teamSequint/sequint/sequint.brd

## EAGLE design sequint.brd (2012-04-18)

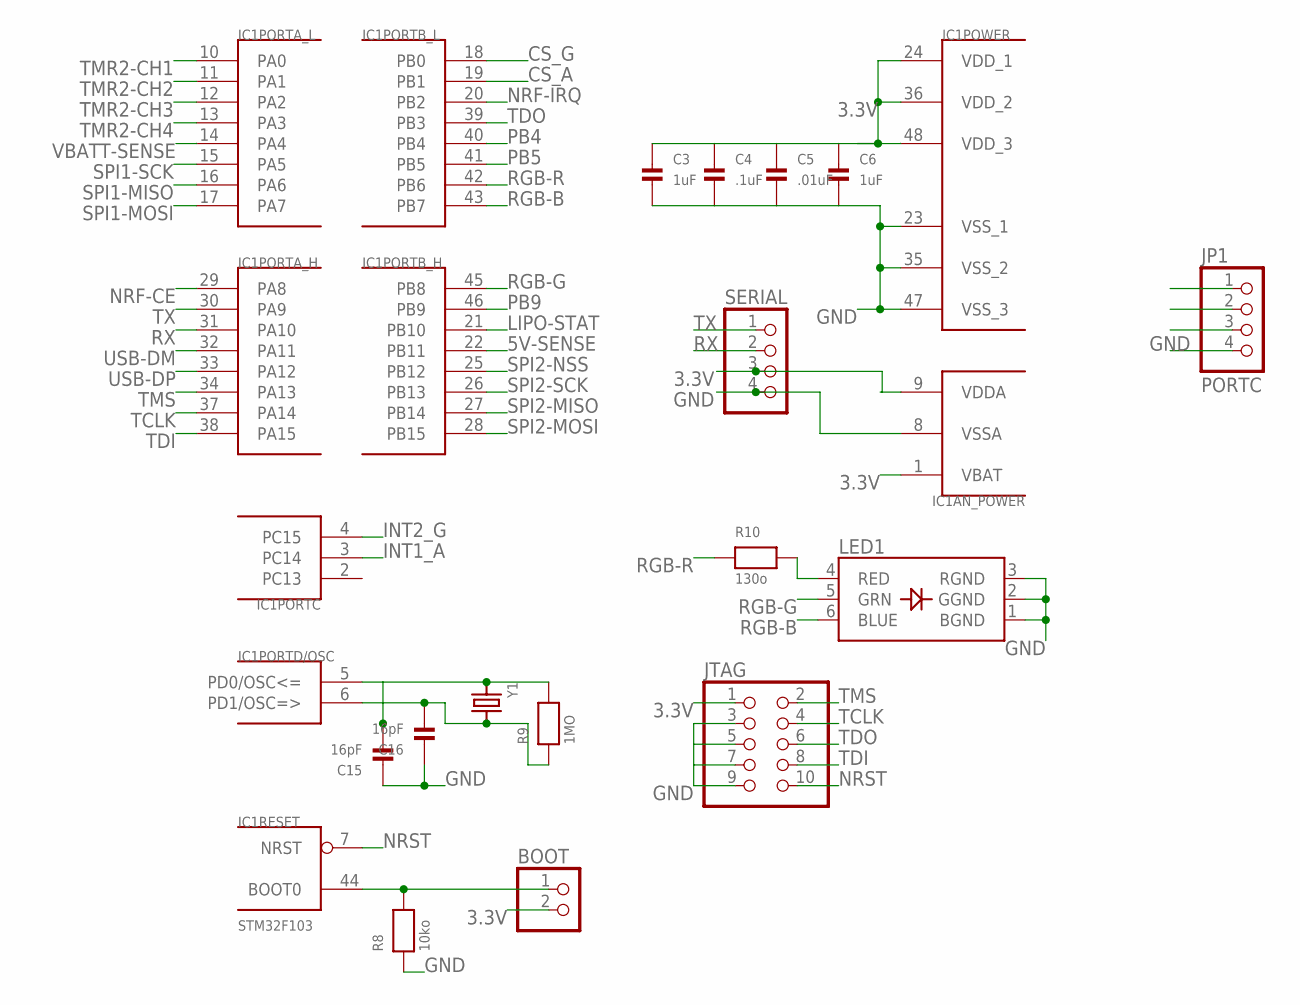
[picture p1: schematic sequint.sch, sheet 1]

Parts:
BOOT: HEADER-1X2ROUND; 1X02_ROUND
C3, C6: 1uF; 0402
C4: .1uF; 0402
C5: .01uF; 0402
C15, C16: 16pF; 0402
IC1: STM32F103; TQFP48
JP1: PORTC; 1X04_ROUND
JTAG: HEADER-2X5; 2X05
LED1: LED_RGB_PLCC6CREE-CLV6A; RGBLED_PLCC6
R8: 10ko; 0402
R9: 1MO; 0402
R10: 130o; 0402
SERIAL: HEADER-1X4ROUND; 1X04_ROUND
Y1: CRYSTALSMD; HC49UP

Connections:
3.3V: BOOT.2, C3.1, C4.1, C5.1, C6.1, IC1.1 (VBAT), IC1.9 (VDDA), IC1.24 (VDD_1), IC1.36 (VDD_2), IC1.48 (VDD_3), JTAG.1, SERIAL.3; also elsewhere on the board
5V-SENSE: IC1.22 (PB11); also elsewhere on the board
BOOT0: BOOT.1, IC1.44 (BOOT0), R8.2
CS_A: IC1.19 (PB1); also elsewhere on the board
CS_G: IC1.18 (PB0); also elsewhere on the board
GND: C3.2, C4.2, C5.2, C6.2, C15.1, C16.1, IC1.8 (VSSA), IC1.23 (VSS_1), IC1.35 (VSS_2), IC1.47 (VSS_3), JP1.4, JTAG.3, JTAG.5, JTAG.7, JTAG.9, LED1.1 (BGND), LED1.2 (GGND), LED1.3 (RGND), R8.1, SERIAL.4; also elsewhere on the board
INT1_A: IC1.3 (PC14); also elsewhere on the board
INT2_G: IC1.4 (PC15); also elsewhere on the board
LIPO-STAT: IC1.21 (PB10); also elsewhere on the board
NRF-CE: IC1.29 (PA8); also elsewhere on the board
NRF-IRQ: IC1.20 (PB2); also elsewhere on the board
NRST: IC1.7 (NRST), JTAG.10
PB4: IC1.40 (PB4), JP1.1
PB5: IC1.41 (PB5), JP1.2
PB9: IC1.46 (PB9), JP1.3
PD0: C15.2, IC1.5 (PD0/OSC<=), R9.2, Y1.1
PD1: C16.2, IC1.6 (PD1/OSC=>), R9.1, Y1.2
RGB-B: IC1.43 (PB7), LED1.6 (BLUE)
RGB-G: IC1.45 (PB8), LED1.5 (GRN)
RGB-R: IC1.42 (PB6), R10.1
RGB-RP: LED1.4 (RED), R10.2
RX: IC1.31 (PA10), SERIAL.2
SPI1-MISO: IC1.16 (PA6); also elsewhere on the board
SPI1-MOSI: IC1.17 (PA7); also elsewhere on the board
SPI1-SCK: IC1.15 (PA5); also elsewhere on the board
SPI2-MISO: IC1.27 (PB14); also elsewhere on the board
SPI2-MOSI: IC1.28 (PB15); also elsewhere on the board
SPI2-NSS: IC1.25 (PB12); also elsewhere on the board
SPI2-SCK: IC1.26 (PB13); also elsewhere on the board
TCLK: IC1.37 (PA14), JTAG.4
TDI: IC1.38 (PA15), JTAG.8
TDO: IC1.39 (PB3), JTAG.6
TMR2-CH1: IC1.10 (PA0); also elsewhere on the board
TMR2-CH2: IC1.11 (PA1); also elsewhere on the board
TMR2-CH3: IC1.12 (PA2); also elsewhere on the board
TMR2-CH4: IC1.13 (PA3); also elsewhere on the board
TMS: IC1.34 (PA13), JTAG.2
TX: IC1.30 (PA9), SERIAL.1
USB-DM: IC1.32 (PA11); also elsewhere on the board
USB-DP: IC1.33 (PA12); also elsewhere on the board
VBATT-SENSE: IC1.14 (PA4); also elsewhere on the board

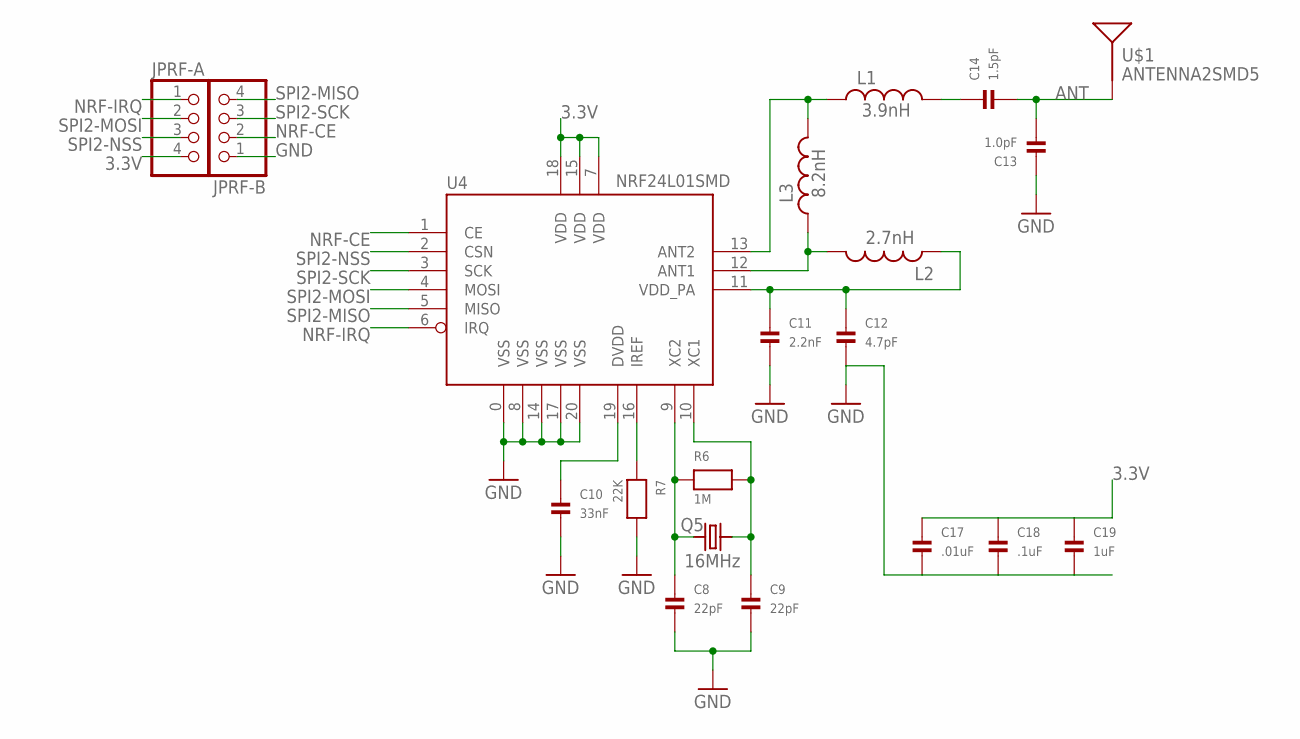
[picture p2: schematic sequint.sch, sheet 2]

Parts:
C8, C9: 22pF; 0402
C10: 33nF; 0402
C11: 2.2nF; 0402
C12: 4.7pF; 0402
C13: 1.0pF; 0402
C14: 1.5pF; 0402
C17: .01uF; 0402
C18: .1uF; 0402
C19: 1uF; 0402
JPRF-A: HEADER-1X4ROUND; 1X04_ROUND
JPRF-B: HEADER-1X4ROUND; 1X04_ROUND
L1: 3.9nH; C0402
L2: 2.7nH; C0402
L3: 8.2nH; C0402
Q5: 16MHz; HC49UP
R6: 1M; 0402
R7: 22K; 0402
U4: NRF24L01SMD; QFN20
U$1: ANTENNA2SMD5; ANTENNA-CHIP5

Connections:
3.3V: C17.1, C18.1, C19.1, JPRF-A.4, U4.7 (VDD), U4.15 (VDD), U4.18 (VDD); also elsewhere on the board
ANT: C13.2, C14.2, U$1.FEED
ANT1: L2.2, L3.1, U4.12 (ANT1)
ANT2: L1.1, L3.2, U4.13 (ANT2)
DVDD: C10.1, U4.19 (DVDD)
GND: C8.2, C9.2, C10.2, C11.2, C12.2, C13.1, C17.2, C18.2, C19.2, JPRF-B.1, R7.2, U4.0 (VSS), U4.8 (VSS), U4.14 (VSS), U4.17 (VSS), U4.20 (VSS); also elsewhere on the board
unnamed: C8.1, Q5.1, R6.1, U4.9 (XC2)
unnamed: C9.1, Q5.2, R6.2, U4.10 (XC1)
unnamed: R7.1, U4.16 (IREF)
unnamed: C14.1, L1.2
NRF-CE: JPRF-B.2, U4.1 (CE); also elsewhere on the board
NRF-IRQ: JPRF-A.1, U4.6 (IRQ); also elsewhere on the board
SPI2-MISO: JPRF-B.4, U4.5 (MISO); also elsewhere on the board
SPI2-MOSI: JPRF-A.2, U4.4 (MOSI); also elsewhere on the board
SPI2-NSS: JPRF-A.3, U4.2 (CSN); also elsewhere on the board
SPI2-SCK: JPRF-B.3, U4.3 (SCK); also elsewhere on the board
VDD_PA: C11.1, C12.1, L2.1, U4.11 (VDD_PA)

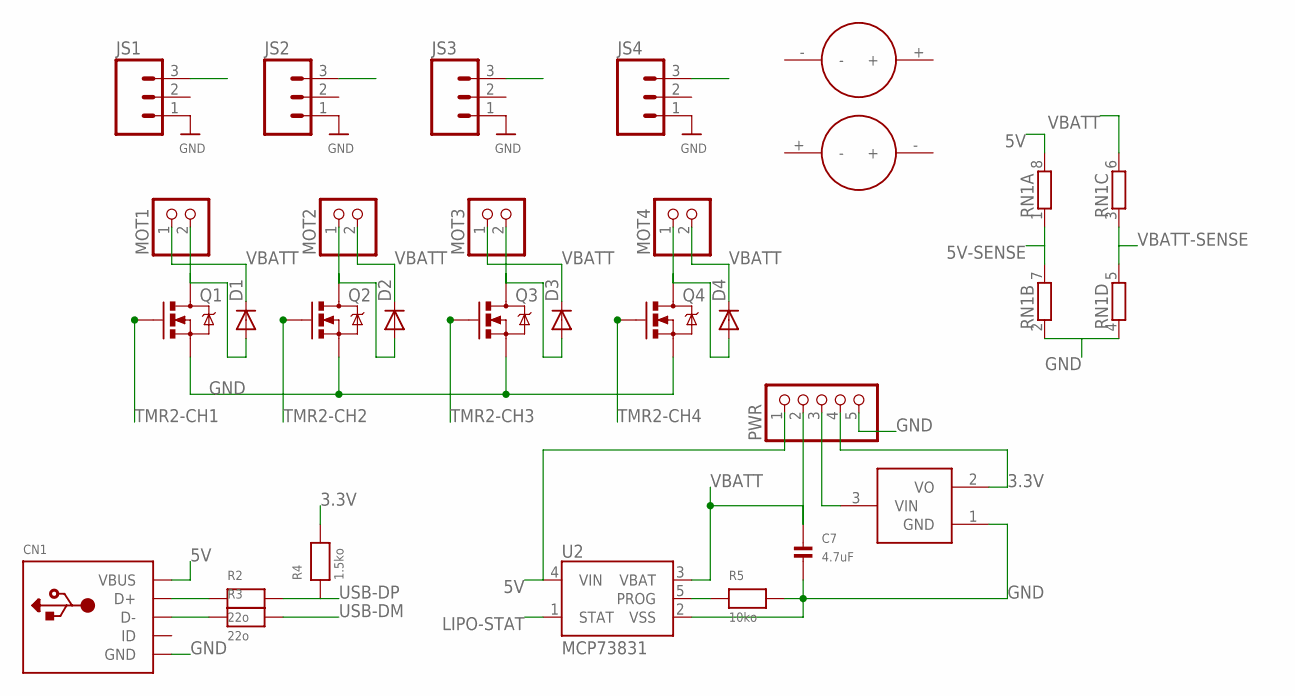
[picture p3: schematic sequint.sch, sheet 3]

Parts:
3.3VREG: VREG; SOT23-3
C7: 4.7uF; 0603
CN1: USBMINIB; USB-MINIB
D1, D2, D3, D4: DIODESOD523; SOD523
JS1, JS2, JS3, JS4: M03LOCK; 1X03_LOCK
MOT1, MOT2, MOT3, MOT4: HEADER-1X2ROUND; 1X02_ROUND
PWR: HEADER-1X5ROUND; 1X05_ROUND
Q1, Q2, Q3, Q4: MOSFET-N; SOT23-3
R2, R3: 22o; 0402
R4: 1.5ko; 0402
R5: 10ko; 0402
RN1: RNETWORK; RN8P-4R-CRA06S
U2: MCP73831; SOT23-5
U$6: MOT_RICCW; MOT_RIC_BM_CW
U$7: MOT_RICCCW; MOT_RIC_BM_CCW

Connections:
3.3V: 3.3VREG.2 (VO), PWR.4, R4.2; also elsewhere on the board
5V: CN1.VBUS, PWR.1, RN1.8 (2), U2.4 (VIN)
5V-SENSE: RN1.1, RN1.7 (2); also elsewhere on the board
GND: 3.3VREG.1 (GND), C7.2, CN1.GND, JS1.1, JS2.1, JS3.1, JS4.1, PWR.5, Q1.2 (S), Q2.2 (S), Q3.2 (S), Q4.2 (S), R5.2, RN1.2 (1), RN1.4 (1), U2.2 (VSS); also elsewhere on the board
LIPO-STAT: U2.1 (STAT); also elsewhere on the board
PROG: R5.1, U2.5 (PROG)
TMR2-CH1: JS1.3, Q1.1 (G); also elsewhere on the board
TMR2-CH2: JS2.3, Q2.1 (G); also elsewhere on the board
TMR2-CH3: JS3.3, Q3.1 (G); also elsewhere on the board
TMR2-CH4: JS4.3, Q4.1 (G); also elsewhere on the board
USB+: CN1.D+, R2.1
USB-: CN1.D-, R3.1
USB-DM: R3.2; also elsewhere on the board
USB-DP: R2.2, R4.1; also elsewhere on the board
VBATT: C7.1, D1.C, D2.C, D3.C, D4.C, MOT1.1, MOT2.2, MOT3.1, MOT4.2, PWR.2, RN1.6 (2), U2.3 (VBAT)
VBATT-SENSE: RN1.3 (1), RN1.5 (2); also elsewhere on the board
VIN_3.3V: 3.3VREG.3 (VIN), PWR.3
VL-1: D1.A, MOT1.2, Q1.3 (D)
VL-2: D2.A, MOT2.1, Q2.3 (D)
VL-3: D3.A, MOT3.2, Q3.3 (D)
VL-4: D4.A, MOT4.1, Q4.3 (D)

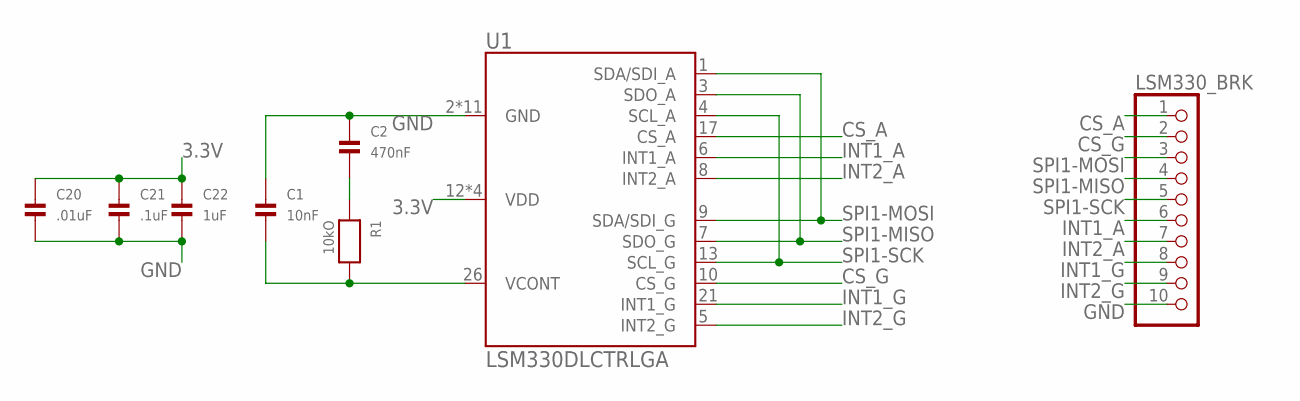
[picture p4: schematic sequint.sch, sheet 4]

Parts:
C1: 10nF; 0402
C2: 470nF; 0402
C20: .01uF; 0402
C21: .1uF; 0402
C22: 1uF; 0402
LSM330_BRK: HEADER-1X10ROUND; 1X10_ROUND
R1: 10kO; 0402
U1: LSM330DLCTRLGA; LGA28L

Connections:
3.3V: C20.1, C21.1, C22.1, U1.12 (VDD), U1.15 (VDD), U1.22 (VDD), U1.28 (VDD); also elsewhere on the board
CS_A: LSM330_BRK.1, U1.17 (CS_A); also elsewhere on the board
CS_G: LSM330_BRK.2, U1.10 (CS_G); also elsewhere on the board
GND: C1.1, C2.1, C20.2, C21.2, C22.2, LSM330_BRK.10, U1.2 (GND), U1.11 (GND), U1.14 (GND), U1.16 (GND), U1.18 (GND), U1.19 (GND), U1.20 (GND), U1.23 (GND), U1.24 (GND), U1.25 (GND), U1.27 (GND); also elsewhere on the board
INT1_A: LSM330_BRK.6, U1.6 (INT1_A); also elsewhere on the board
INT1_G: LSM330_BRK.8, U1.21 (INT1_G)
INT2_A: LSM330_BRK.7, U1.8 (INT2_A)
INT2_G: LSM330_BRK.9, U1.5 (INT2_G); also elsewhere on the board
SPI1-MISO: LSM330_BRK.4, U1.3 (SDO_A), U1.7 (SDO_G); also elsewhere on the board
SPI1-MOSI: LSM330_BRK.3, U1.1 (SDA/SDI_A), U1.9 (SDA/SDI_G); also elsewhere on the board
SPI1-SCK: LSM330_BRK.5, U1.4 (SCL_A), U1.13 (SCL_G); also elsewhere on the board
VCONT: C1.2, R1.2, U1.26 (VCONT)
VCONT_1: C2.2, R1.1

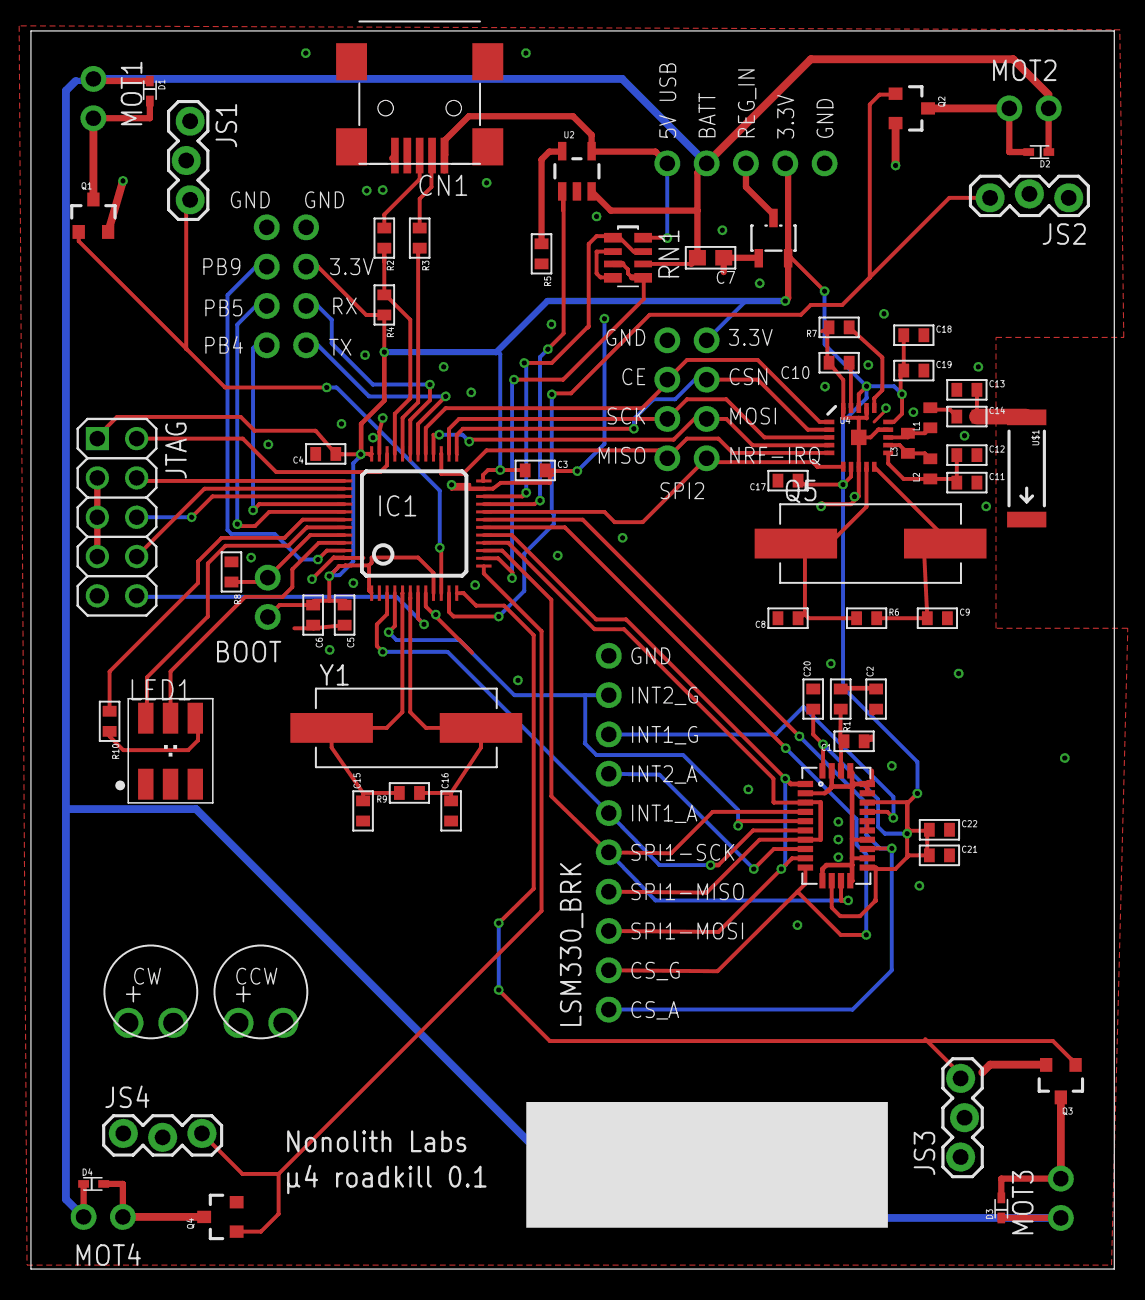
[picture p5: board sequint.brd from above]

Board: 2 copper layers, 70.0 x 80.0 mm, 72 parts (0 on the bottom side), 64 nets.
