teamSequint/sequint/(commit log)

2012-03-19 f1rst p0st!
    [sequint.sch]
2012-03-20 preliminary component groupings and some routing done on roadkill board. 2 layers.
    [sequint.brd]
2012-03-20 fyeahgroundplane and fyeahproperboardsizing
    [sequint.brd]
2012-03-20 all sheets routed and roughly placed. sheet-to-sheet connections underway. 2 layers, 16 mil pwr, 12 mil sig.
    [sequint.brd]
2012-03-22 Roadkill routed. Fails DRC for reasons that will be easy to fix after a good night's sleep. I isolated the antenna trace...should I? 10 mils min, 2 layer, motors on corners, one heck of a rat's nest.
    [sequint.brd]
2012-03-23 Fix routing
    [sequint.brd, sequint.sch]
2012-03-23 fix airwire
    [sequint.brd]
2012-03-23 DRC / cleanup
    [sequint.brd]
2012-03-23 More routing tweaks
    [sequint.brd]
2012-03-23 Break out portC
    [sequint.brd, sequint.sch]
2012-03-23 Fix airwires
    [sequint.brd]
2012-03-23 Roadkill passes all meaninful DRC (clearance issues around all the fine-pitch ICs). Added silkscreen for name, rev, serial. Logo in copper?
    [sequint.brd]
2012-03-26 label header pins
    [sequint.brd]
2012-03-28 Some non-power traces were 12mil. Make them 10mil
    [sequint.brd]
2012-04-02 updated nonolith.lbr
    [sequint.brd, sequint.sch]
2012-04-03 s/trace antenna/chip antenna/, passes DRC.
    [sequint.brd, sequint.sch]
2012-04-04 fix nRF pin names
    [sequint.brd]
2012-04-04 removed fatty diodes, s/0603/0402/
    [sequint.brd, sequint.sch]
2012-04-04 fixed DRC errors
    [sequint.brd]
2012-04-04 added snubber diodes in SOD523 aka tiny
    [sequint.brd, sequint.sch]
2012-04-04 Pack radio tighter. Add GND vias
    [sequint.brd]
2012-04-04 Make GND plane cutout rectangular
    [sequint.brd]
2012-04-04 Vias around USB
    [sequint.brd]
2012-04-06 Add servo headers
    [sequint.brd, sequint.sch]
2012-04-16 Add test motor footprint
    [sequint.brd, sequint.sch]
2012-04-16 Fix routing on two STM32 pins; update lbr
    [sequint.brd, sequint.sch]
2012-04-17 Move nrf-ce to pin 31 for better routing
    [sequint.brd, sequint.sch]
2012-04-17 rearrange more pins
    [sequint.brd, sequint.sch]
2012-04-17 Move LED
    [sequint.brd]
2012-04-17 Move USART to USART1, which supports bootloader.
    [sequint.brd, sequint.sch]
2012-04-17 Clean up
    [sequint.brd]
