teamSequint/sequint/(notices)

Notices in the files:
parts and their libraries:
SparkFun: Licensing: CC v3.0 Share-Alike You are welcome to use this library for commercial purposes.
